alvaroalea/electronica-reespirator23-17/README.md

# electronica-reespirator23-17
Mi propia version del Reespirator23

Completamente usando una impresora 3D, sin falta de Corte laser.
Con Motores Nema 17 (los habituales de las impresoras 3D).

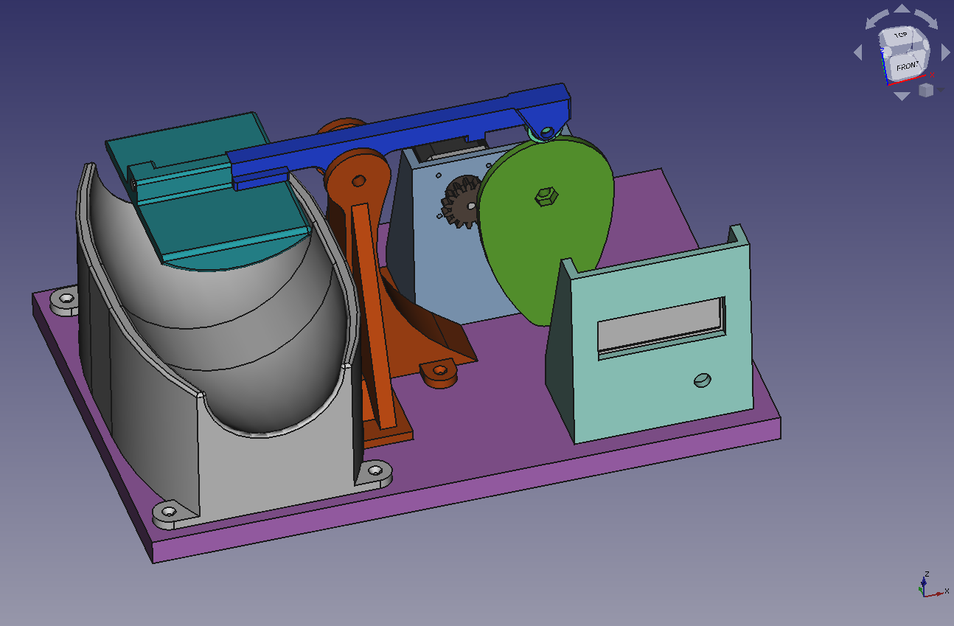
[picture p1: imagen.png]
My image
