alvaroalea/electronica-reespirator23-17/Archivos-Reespirator-23/respirador23.0.1.FCStd

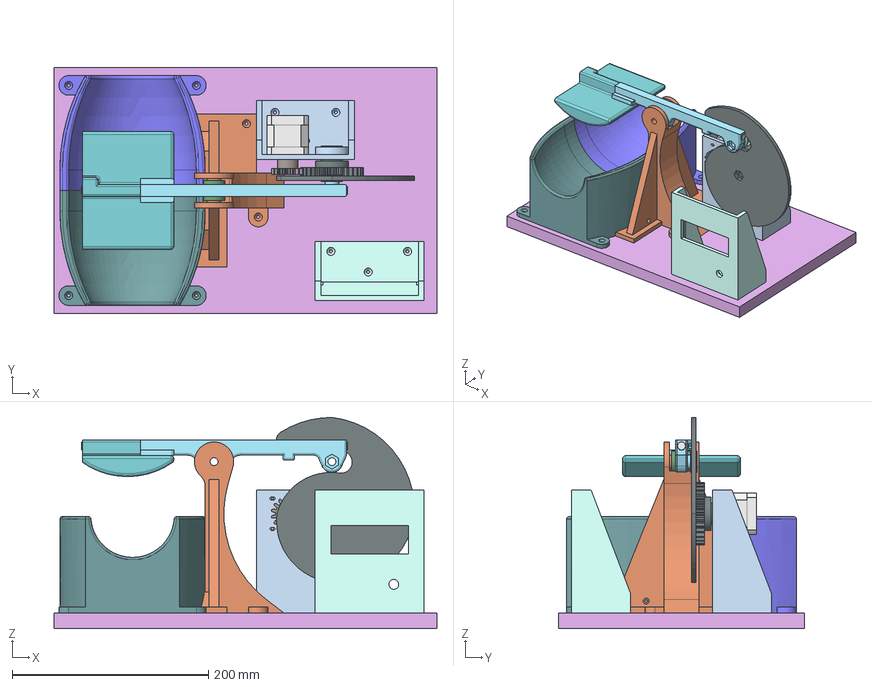
[picture p16: CAD file, 2020-03-27]
Archivos-Reespirator-23/respirador23.0.1.FCStd
390.0 x 250.0 x 215.0 mm
608ZZ (Solid)002
608ZZ (Solid)003
608ZZ (Solid)004
barra refuerzo
base
engranaje_peque
leva001
Nema-17-motor-40mm-final
608ZZ (Solid)005
608ZZ (Solid)006
soporte_motor
soporte_LCD
soporte_eje
soporte_balon001
soporte_balon002
