alvaroalea/electronica-reespirator23-17/Archivos-Reespirator-23/respirador23/Reespirator23_Reespirator23_stp_1_conjunto_stp_1_separador_eje_principal.STL

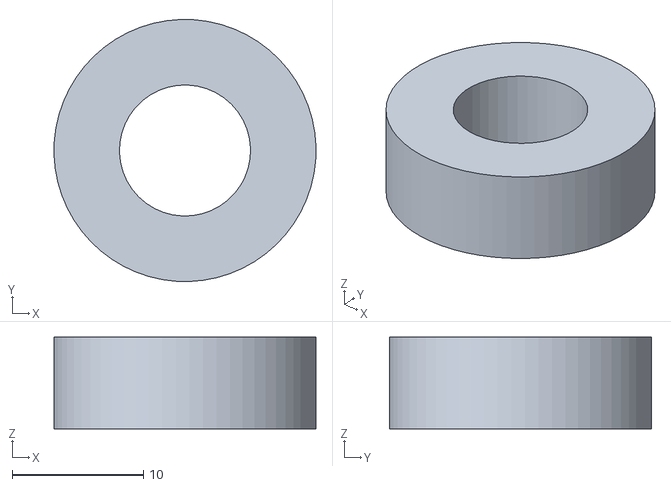
[picture p17: CAD file, 2020-03-22]
Archivos-Reespirator-23/respirador23/Reespirator23_Reespirator23_stp_1_conjunto_stp_1_separador_eje_principal.STL
20.0 x 20.0 x 7.00
