alvaroalea/electronica-reespirator23-17/Archivos-Reespirator-23/STL/brazo.stl

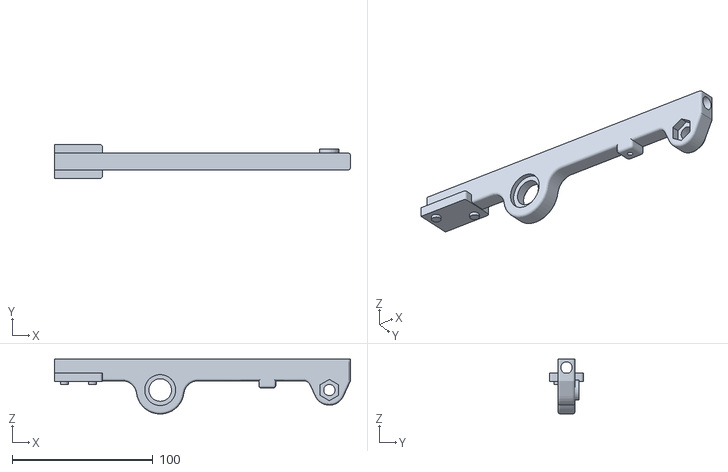
[picture p18: CAD file, 2020-03-27]
Archivos-Reespirator-23/STL/brazo.stl
210.0 x 24.0 x 39.0
