alvaroalea/electronica-reespirator23-17/modificacion_2n.stl

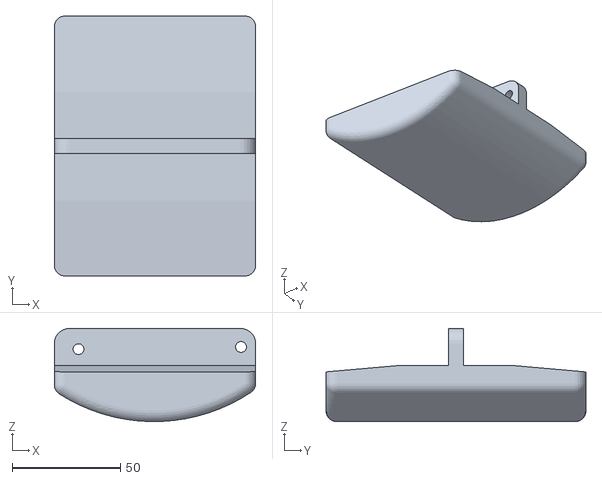
[picture p19: CAD file, 2020-03-22]
modificacion_2n.stl
93.0 x 120.0 x 43.0
