alvaroalea/electronica-reespirator23-17/Archivos-Reespirator-23/respirador23/Reespirator23 - Reespirator23.stp-1 leva.stp-1.STL

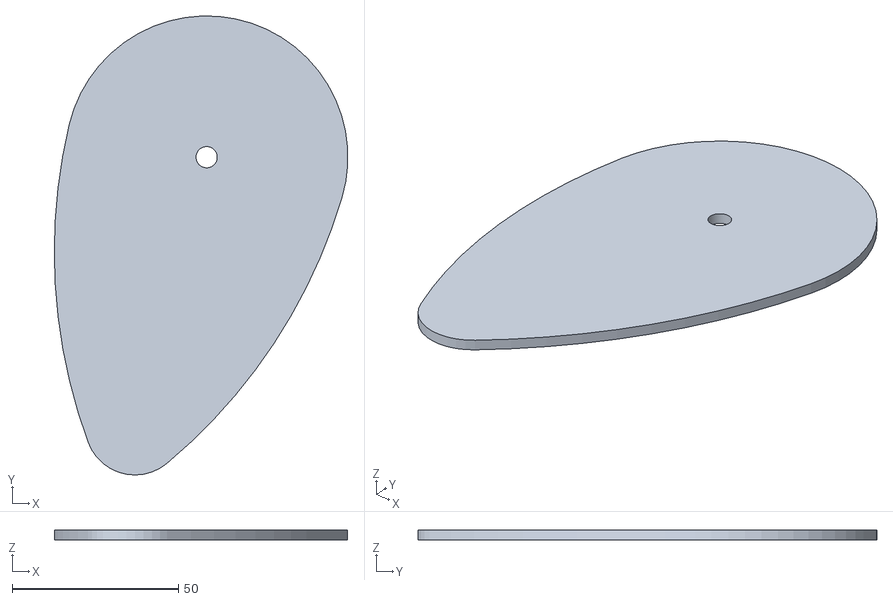
[picture p21: CAD file, 2020-03-22]
Archivos-Reespirator-23/respirador23/Reespirator23 - Reespirator23.stp-1 leva.stp-1.STL
88.3 x 138.1 x 3.00
