alvaroalea/electronica-reespirator23-17/Archivos-Reespirator-23/STL/leva.stl

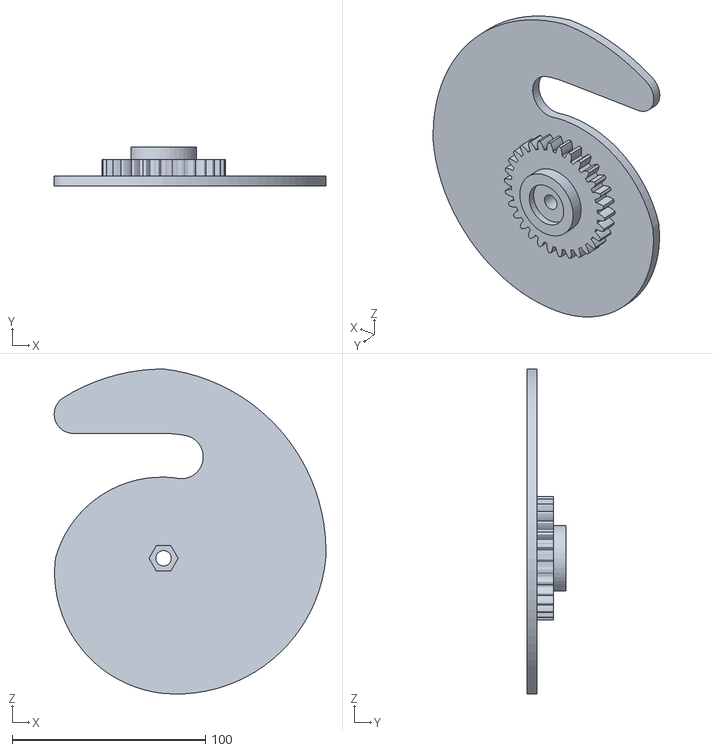
[picture p22: CAD file, 2020-03-27]
Archivos-Reespirator-23/STL/leva.stl
140.7 x 20.0 x 168.3
