alvaroalea/electronica-reespirator23-17/Archivos-Reespirator-23/STL/soporte_motor.stl

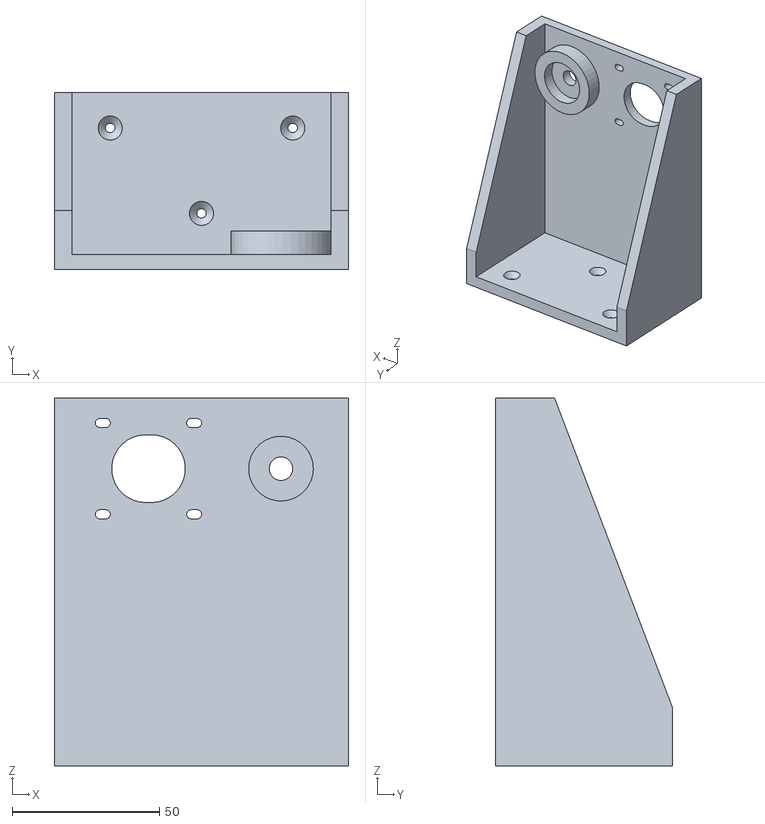
[picture p23: CAD file, 2020-03-25]
Archivos-Reespirator-23/STL/soporte_motor.stl
100.0 x 60.0 x 125.0
