alvaroalea/electronica-reespirator23-17/Archivos-Reespirator-23/respirador23/Reespirator23_Reespirator23_stp_1_conjunto_stp_1_item_8_0_004_12.STL

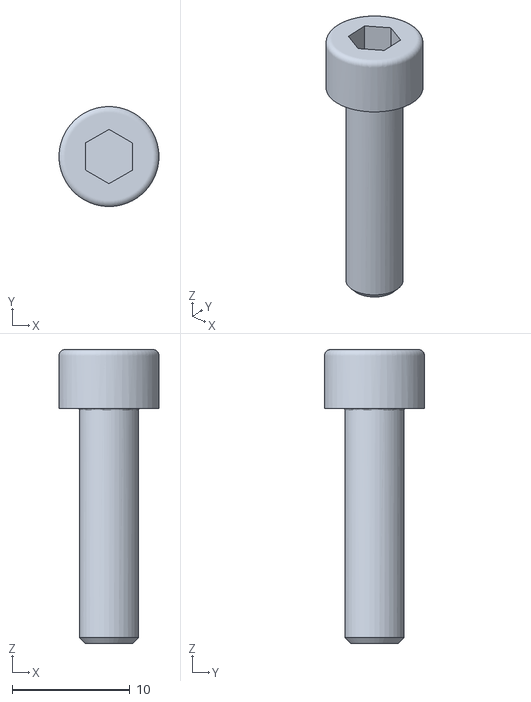
[picture p24: CAD file, 2020-03-22]
Archivos-Reespirator-23/respirador23/Reespirator23_Reespirator23_stp_1_conjunto_stp_1_item_8_0_004_12.STL
8.50 x 8.49 x 25.0
