alvaroalea/electronica-reespirator23-17/Archivos-Reespirator-23/STL/soporte_balon.stl

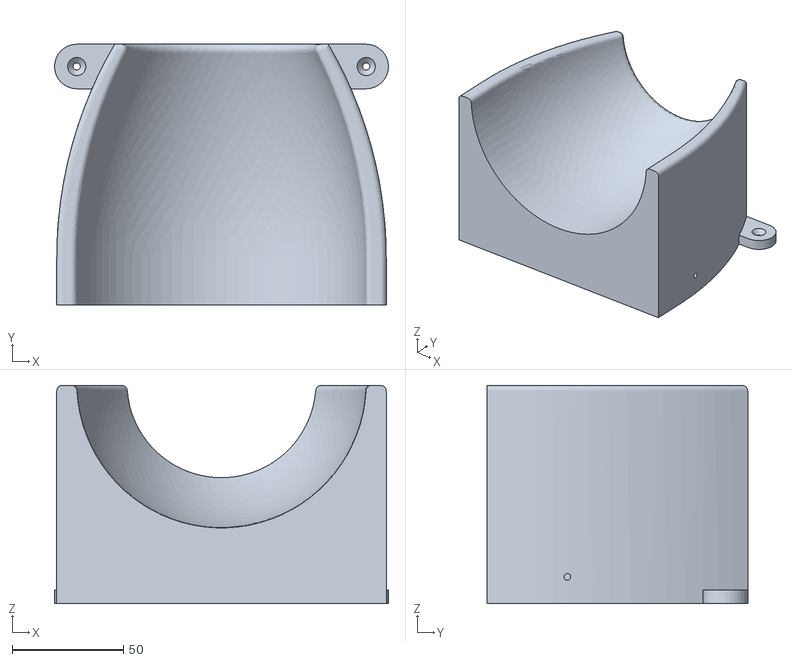
[picture p25: CAD file, 2020-03-25]
Archivos-Reespirator-23/STL/soporte_balon.stl
150.0 x 117.0 x 98.0
