alvaroalea/electronica-reespirator23-17/Archivos-Reespirator-23/respirador23/Reespirator23_Reespirator23_stp_1_conjunto_stp_1_tuerca_din934_m5.STL

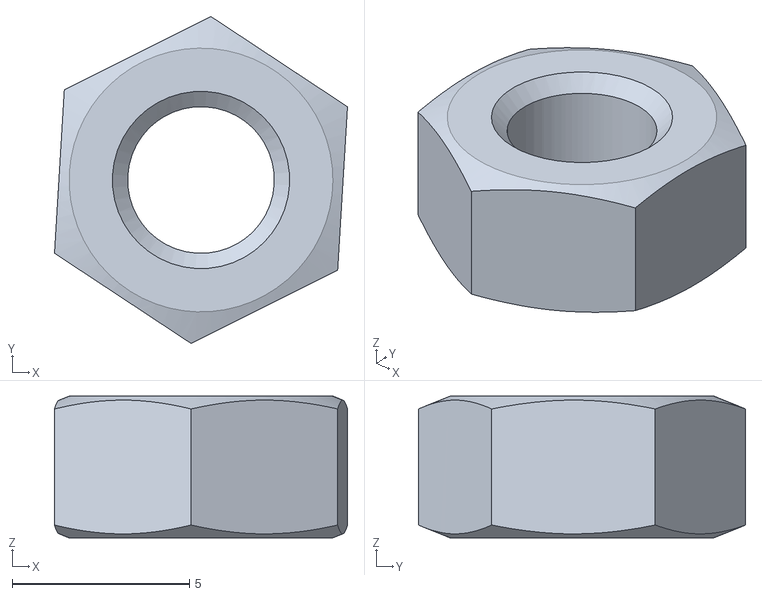
[picture p26: CAD file, 2020-03-22]
Archivos-Reespirator-23/respirador23/Reespirator23_Reespirator23_stp_1_conjunto_stp_1_tuerca_din934_m5.STL
8.26 x 9.22 x 4.00
