alvaroalea/electronica-reespirator23-17/Archivos-Reespirator-23/STL/empujador.stl

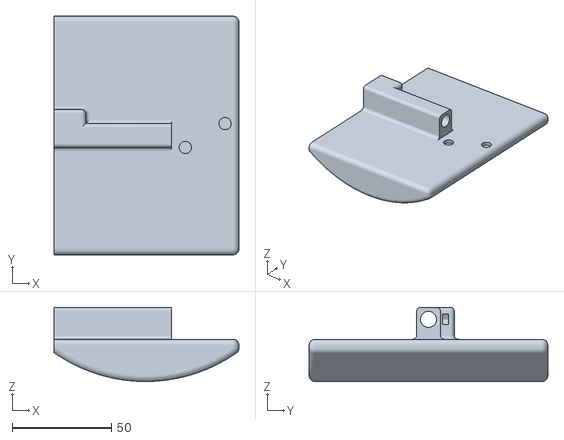
[picture p27: CAD file, 2020-03-25]
Archivos-Reespirator-23/STL/empujador.stl
93.0 x 120.0 x 37.3
