alvaroalea/electronica-reespirator23-17/Archivos-Reespirator-23/respirador23/Reespirator23 - Reespirator23.stp-1 Pieza15.stp-1.STL

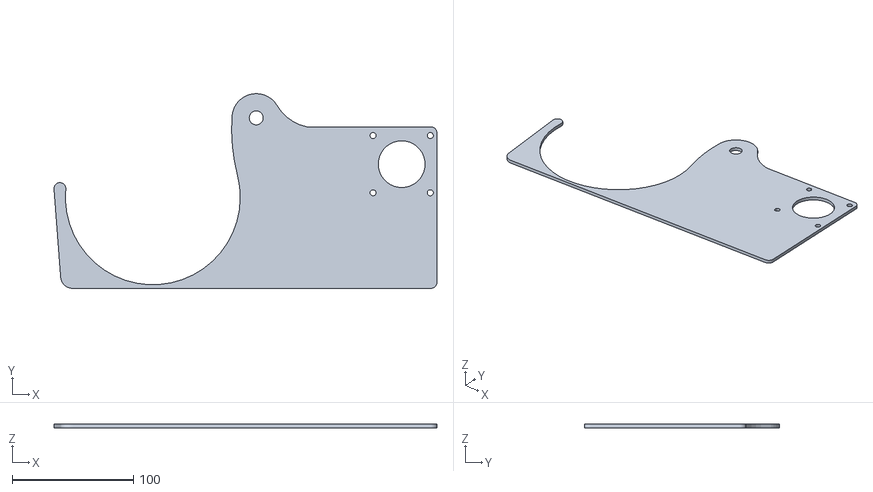
[picture p28: CAD file, 2020-03-22]
Archivos-Reespirator-23/respirador23/Reespirator23 - Reespirator23.stp-1 Pieza15.stp-1.STL
315.4 x 160.4 x 3.00
