alvaroalea/electronica-reespirator23-17/Archivos-Reespirator-23/STL/soporte_lcd.stl

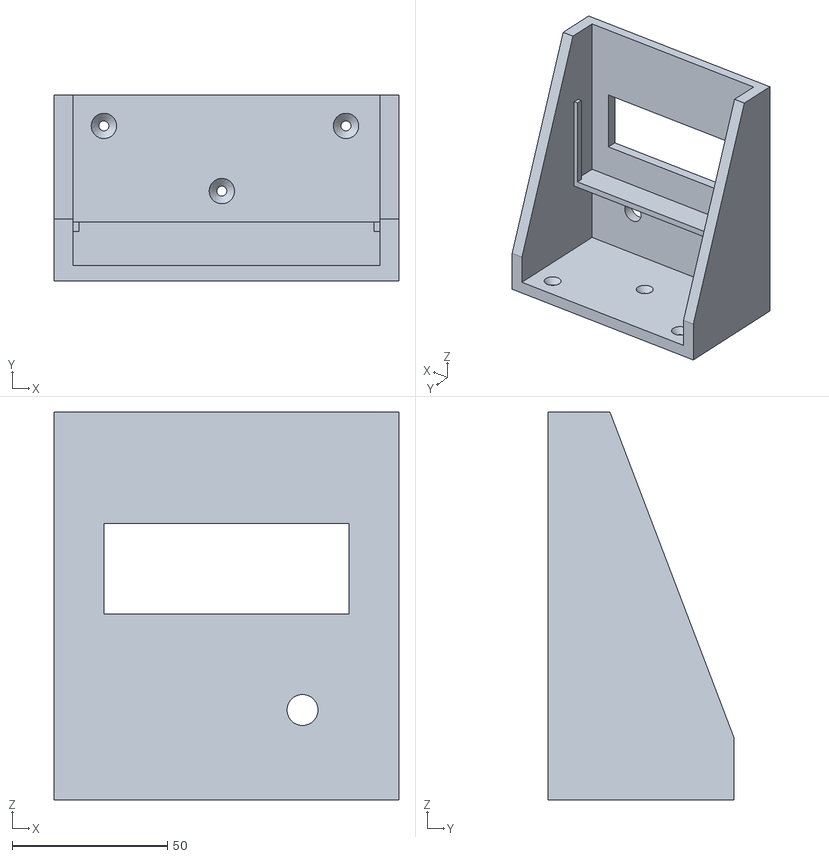
[picture p29: CAD file, 2020-03-23]
Archivos-Reespirator-23/STL/soporte_lcd.stl
111.0 x 60.0 x 125.0
