alvaroalea/electronica-reespirator23-17/Archivos-Reespirator-23/respirador23/Reespirator23 - Reespirator23.stp-1 Base_23.stp-1.STL

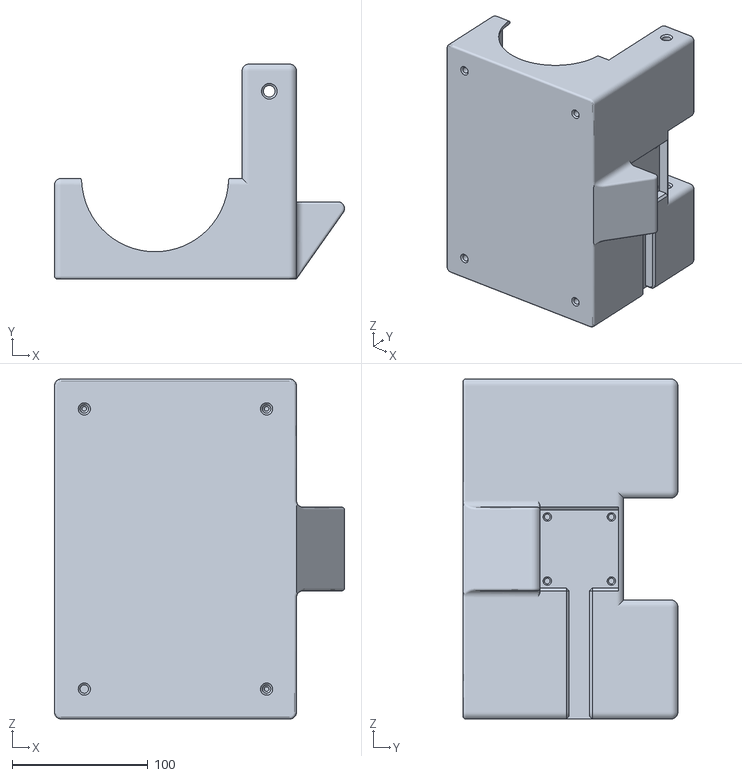
[picture p30: CAD file, 2020-03-22]
Archivos-Reespirator-23/respirador23/Reespirator23 - Reespirator23.stp-1 Base_23.stp-1.STL
213.4 x 158.0 x 250.0
