alvaroalea/electronica-reespirator23-17/Archivos-Reespirator-23/STL/soporte_eje.stl

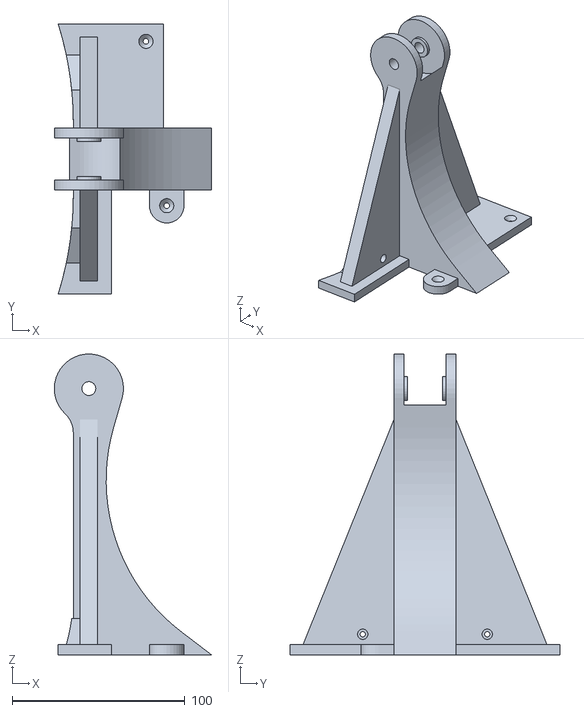
[picture p31: CAD file, 2020-03-23]
Archivos-Reespirator-23/STL/soporte_eje.stl
91.0 x 156.0 x 174.0
