alvaroalea/electronica-reespirator23-17/Archivos-Reespirator-23/respirador23/Reespirator23_Reespirator23_stp_1_conjunto_stp_1_AR_M5_stp_4.STL

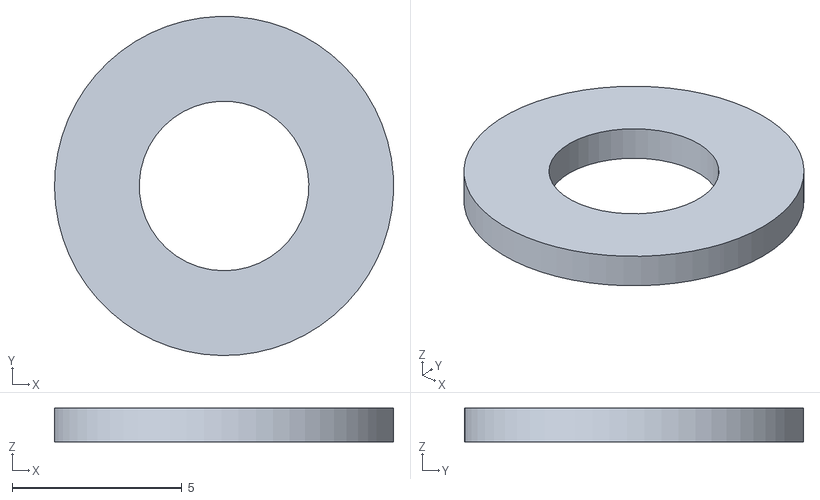
[picture p32: CAD file, 2020-03-22]
Archivos-Reespirator-23/respirador23/Reespirator23_Reespirator23_stp_1_conjunto_stp_1_AR_M5_stp_4.STL
10.00 x 10.00 x 1.00
