alvaroalea/electronica-reespirator23-17/Archivos-Reespirator-23/STL/engranaje.stl

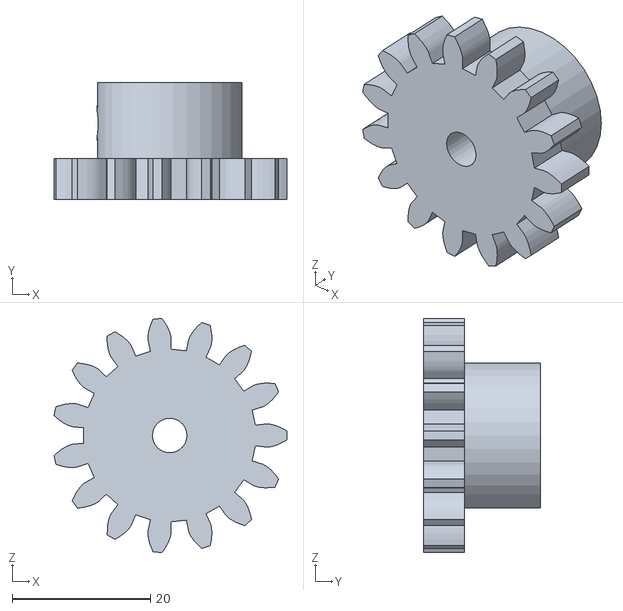
[picture p33: CAD file, 2020-03-23]
Archivos-Reespirator-23/STL/engranaje.stl
33.7 x 17.0 x 33.9
