alvaroalea/electronica-reespirator23-17/Archivos-Reespirator-23/respirador23/Reespirator23_Reespirator23_stp_1_conjunto_stp_1_bearing_625zz_0.STL

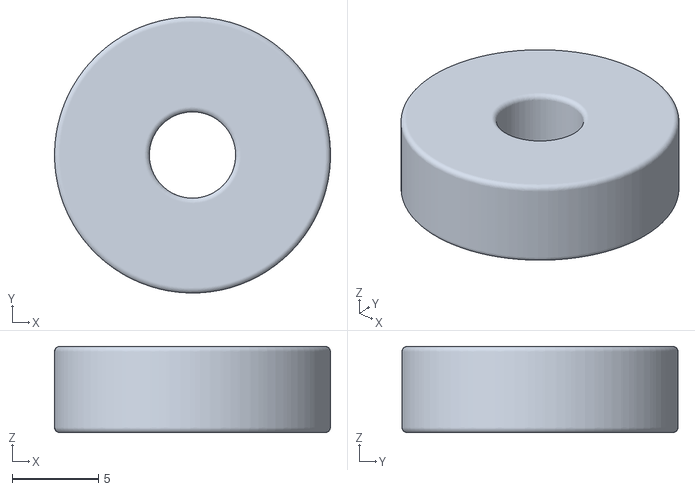
[picture p34: CAD file, 2020-03-22]
Archivos-Reespirator-23/respirador23/Reespirator23_Reespirator23_stp_1_conjunto_stp_1_bearing_625zz_0.STL
16.0 x 16.0 x 5.00
