alvaroalea/electronica-reespirator23-17/Archivos-Reespirator-23/respirador23/Reespirator23.stp

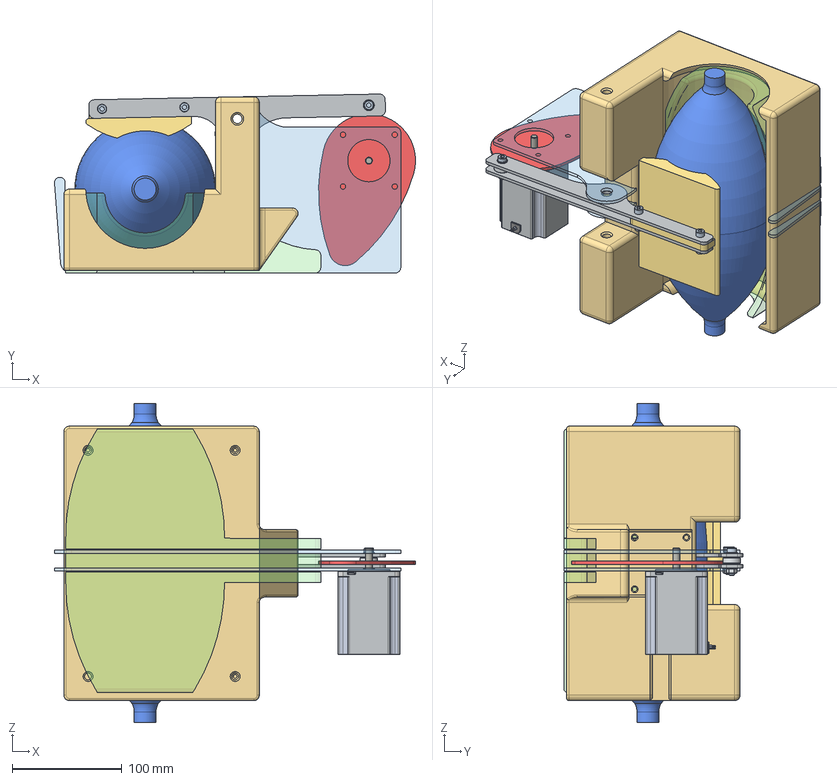
[picture p35: CAD file, 2020-03-22]
Archivos-Reespirator-23/respirador23/Reespirator23.stp
328.8 x 163.0 x 291.0 mm
Base_23
bearing_625zz_0
palanca-CNC-LASER x 2
AR M5 x 6
empujador
item_8_0_004_12_biq41gv2ypkypls4gfckj5y0b x 3
tuerca_din934_m5-10 x 5
separador-eje-principal
balloon
NEMA23 57BYGH627
Pieza15 x 2
leva
soporte-globo
