alvaroalea/electronica-reespirator23-17/Archivos-Reespirator-23/respirador23/Reespirator23 - Reespirator23.stp-1 NEMA23 57BYGH627.stp-1.STL

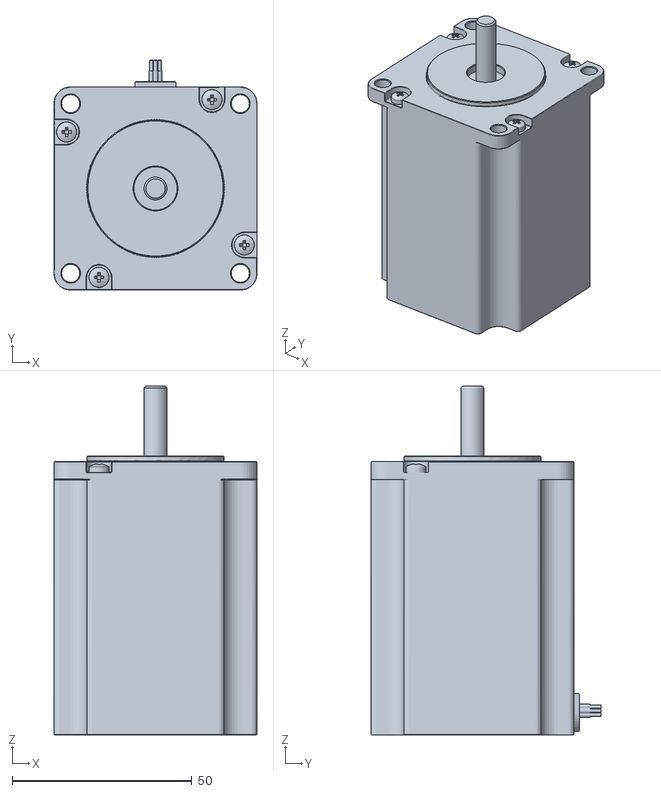
[picture p36: CAD file, 2020-03-22]
Archivos-Reespirator-23/respirador23/Reespirator23 - Reespirator23.stp-1 NEMA23 57BYGH627.stp-1.STL
56.4 x 63.9 x 97.0
