alvaroalea/electronica-reespirator23-17/Archivos-Reespirator-23/respirador23/Reespirator23 - Reespirator23.stp-1 soporte-globo.stp-1.STL

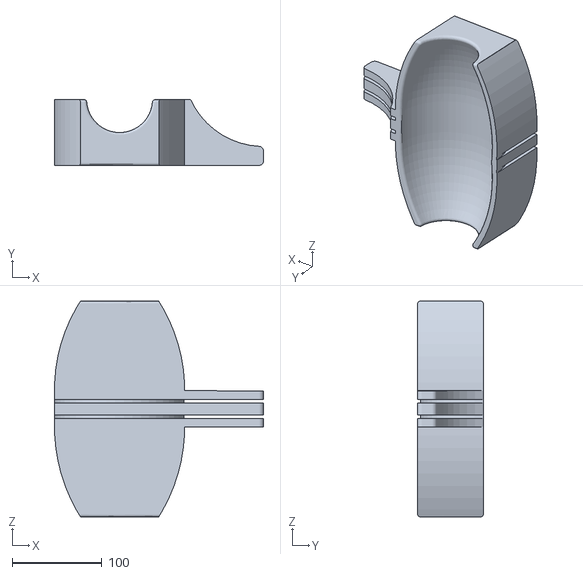
[picture p39: CAD file, 2020-03-22]
Archivos-Reespirator-23/respirador23/Reespirator23 - Reespirator23.stp-1 soporte-globo.stp-1.STL
232.4 x 73.1 x 240.0
