alvaroalea/electronica-reespirator23-17/(list of files, cad)

Other CAD files:
Archivos-Reespirator-23/respirador23/Reespirator23_Reespirator23_stp_1_conjunto_stp_1_AR_M5_stp_1.STL
Archivos-Reespirator-23/respirador23/Reespirator23_Reespirator23_stp_1_conjunto_stp_1_AR_M5_stp_2.STL
Archivos-Reespirator-23/respirador23/Reespirator23_Reespirator23_stp_1_conjunto_stp_1_AR_M5_stp_5.STL
Archivos-Reespirator-23/respirador23/Reespirator23_Reespirator23_stp_1_conjunto_stp_1_AR_M5_stp_3.STL
Archivos-Reespirator-23/respirador23/Reespirator23_Reespirator23_stp_1_conjunto_stp_1_AR_M5_stp_6.STL
Archivos-Reespirator-23/respirador23/Reespirator23 - Reespirator23.stp-1 Pieza15.stp-2.STL
Archivos-Reespirator-23/respirador23/Reespirator23_Reespirator23_stp_1_conjunto_stp_1_item_8_0_004_12 (2).STL
Archivos-Reespirator-23/respirador23/Reespirator23_Reespirator23_stp_1_conjunto_stp_1_item_8_0_004_12 (3).STL
Archivos-Reespirator-23/respirador23/Reespirator23_Reespirator23_stp_1_conjunto_stp_1_palanca_CNC_LASER (2).STL
Archivos-Reespirator-23/respirador23/Reespirator23_Reespirator23_stp_1_conjunto_stp_1_tuerca_din934_m5 (2).STL
Archivos-Reespirator-23/respirador23/Reespirator23_Reespirator23_stp_1_conjunto_stp_1_tuerca_din934_m5 (3).STL
Archivos-Reespirator-23/respirador23/Reespirator23_Reespirator23_stp_1_conjunto_stp_1_tuerca_din934_m5 (4).STL
Archivos-Reespirator-23/respirador23/Reespirator23_Reespirator23_stp_1_conjunto_stp_1_tuerca_din934_m5 (5).STL
