alvaroalea/electronica-reespirator23-17/(commit log)

2020-03-23 mi propia version imprimible
    [brazo.stl, empujador.stl, engranaje.stl, leva.stl, respirador23.0.1.FCStd, soporte_balon.stl, soporte_eje.stl, soporte_lcd.stl]
2020-03-25 arreglar hueco de rodamiento y tolerancias
    [brazo.stl, empujador.stl, respirador23.0.1.FCStd]
2020-03-25 mas tolerancia y arreglar el jesus bolt
    [leva.stl, respirador23.0.1.FCStd, soporte_balon.stl, soporte_motor.stl]
2020-03-27 nueva leva
    [brazo.stl, leva.stl, respirador23.0.1.FCStd]
